DangerDexter/eeprom_cpu/(list of files, drawings)

Other design files:
ep16cpu.circ
