DangerDexter/eeprom_cpu/(commit log)

2017-08-08 First version of a working CPU
    After a few days of work, I now have a CPU which can run a program to
    generate the Fibonacci series.
    [eprocpu.circ]
2017-08-22 Update to version 3 of the CPU
    I've actually gone through a second and now a third version of my CPU.
    This one has a 16-bit address bus. I have bought a pile of chips and
    components, and I plan on building it soon.
    [ep16cpu.circ, eprocpu.circ]
